stephenajirioghene-wq/food-spoilage-detector/fridge_monitor/setup_page.html

# FRIDGE001 Wi-Fi setup

The board only joins 2.4 GHz Wi-Fi. Set your phone hotspot to 2.4 GHz (iPhone: turn on "Maximise Compatibility").

Saved network: ...

Networks nearbyRefresh

- Scanning...

Network name (type it for a hidden network) Password Show password Save

Forget saved network
The board then uses the network in secrets.h.

## Experiment

Mode...

experimentId

sampleId

Food

runId

Quality

Settling

Spoilage alert

Baseline

Food reference (record only)

Silence alarm

Board time (WAT)

Waiting to upload

Last app commandnone

StartObservationEventEnd

End the current experiment first

Keep the food out until the LCD shows CAL READY (15 min of clean air after settling, one long beep): the board takes each sensor's baseline from those minutes. Then put the food in and press Start. Food name * experimentId * sampleId * A-Z, 0-9 and - only, 3 to 32 characters. Lower case is converted to upper case. Storage location * Container Covered or open Portion

Cooked at (WAT)Leave blank if unknown. Stored at (WAT)

now

When the sample entered storage. Leave blank if unknown. Recipe or ingredients Prior storage or reheating Other food in the compartment Notes Start experiment

Start an experiment first

Record what you smell or see yourself. The board does not suggest a label from its sensors. Label Method Observed at (WAT, blank = now)

now

Notes Save observation

Start an experiment first

Type

Change

Which power

Time (WAT, blank = now)

now

Door closed at (WAT)

now

A new sample needs a NEW experiment with a new experimentId and sampleId (app team requirements). Log this event, then end the current experiment and start a new one.
Go to End experiment

Notes Log event

No experiment is running

Final status Notes End experiment
