stephenajirioghene-wq/food-spoilage-detector/docs/rice_test_RICE-SPOILT-001/r00062.csv

measuredAt_WAT | minutes_from_rice_in | quality | mq1_V | mq1_Rs_ohm | mq1_ppm | mq1_rail | mq2_V | mq2_Rs_ohm | mq2_ppm | mq2_rail
2026-10-19 22:48:00 | -76.0 | settling | 0.1978 | 49653.9 | 1.165 | 0 | 0.8685 | 6579.6 | 21.135 | 0
2026-10-19 22:49:00 | -75.0 | settling | 0.1505 | 69269.9 | 0.647 | 0 | 0.9117 | 6373.6 | 28.318 | 0
2026-10-19 22:50:00 | -74.0 | settling | 0.1453 | 68853.4 | 0.521 | 0 | 1.3977 | 3540.6 | 111.654 | 0
2026-10-19 22:51:00 | -73.0 | settling | 0.1448 | 68863.7 | 0.53 | 0 | 1.4914 | 3224.2 | 142.495 | 0
2026-10-19 22:52:00 | -72.0 | settling | 0.1316 | 76754.1 | 0.423 | 0 | 0.4073 | 90390.4 | 45.586 | 12
2026-10-19 22:53:00 | -71.0 | settling | 0.1588 | 79574.5 | 0.688 | 0 | 1.094 | 392676.4 | 147.252 | 2
2026-10-19 22:54:00 | -70.0 | settling | 0.1485 | 106818.2 | 0.57 | 0 | 1.6018 | 2907.7 | 189.762 | 0
2026-10-19 22:55:00 | -69.0 | settling | 0.1491 | 66464.4 | 0.561 | 0 | 1.6038 | 2901.5 | 190.519 | 0
2026-10-19 22:56:00 | -68.0 | settling | 0.159 | 63157.7 | 0.691 | 0 | 1.5956 | 2923.5 | 186.565 | 0
2026-10-19 22:57:00 | -67.0 | settling | 0.1472 | 109029.4 | 0.578 | 0 | 1.5619 | 3016 | 171.1 | 0
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
